proboterror/bkm-129x-scart-vga/bkm-129x-scart-vga.kicad_pcb

## KiCad design bkm-129x-scart-vga.kicad_pcb (2025-03-08)

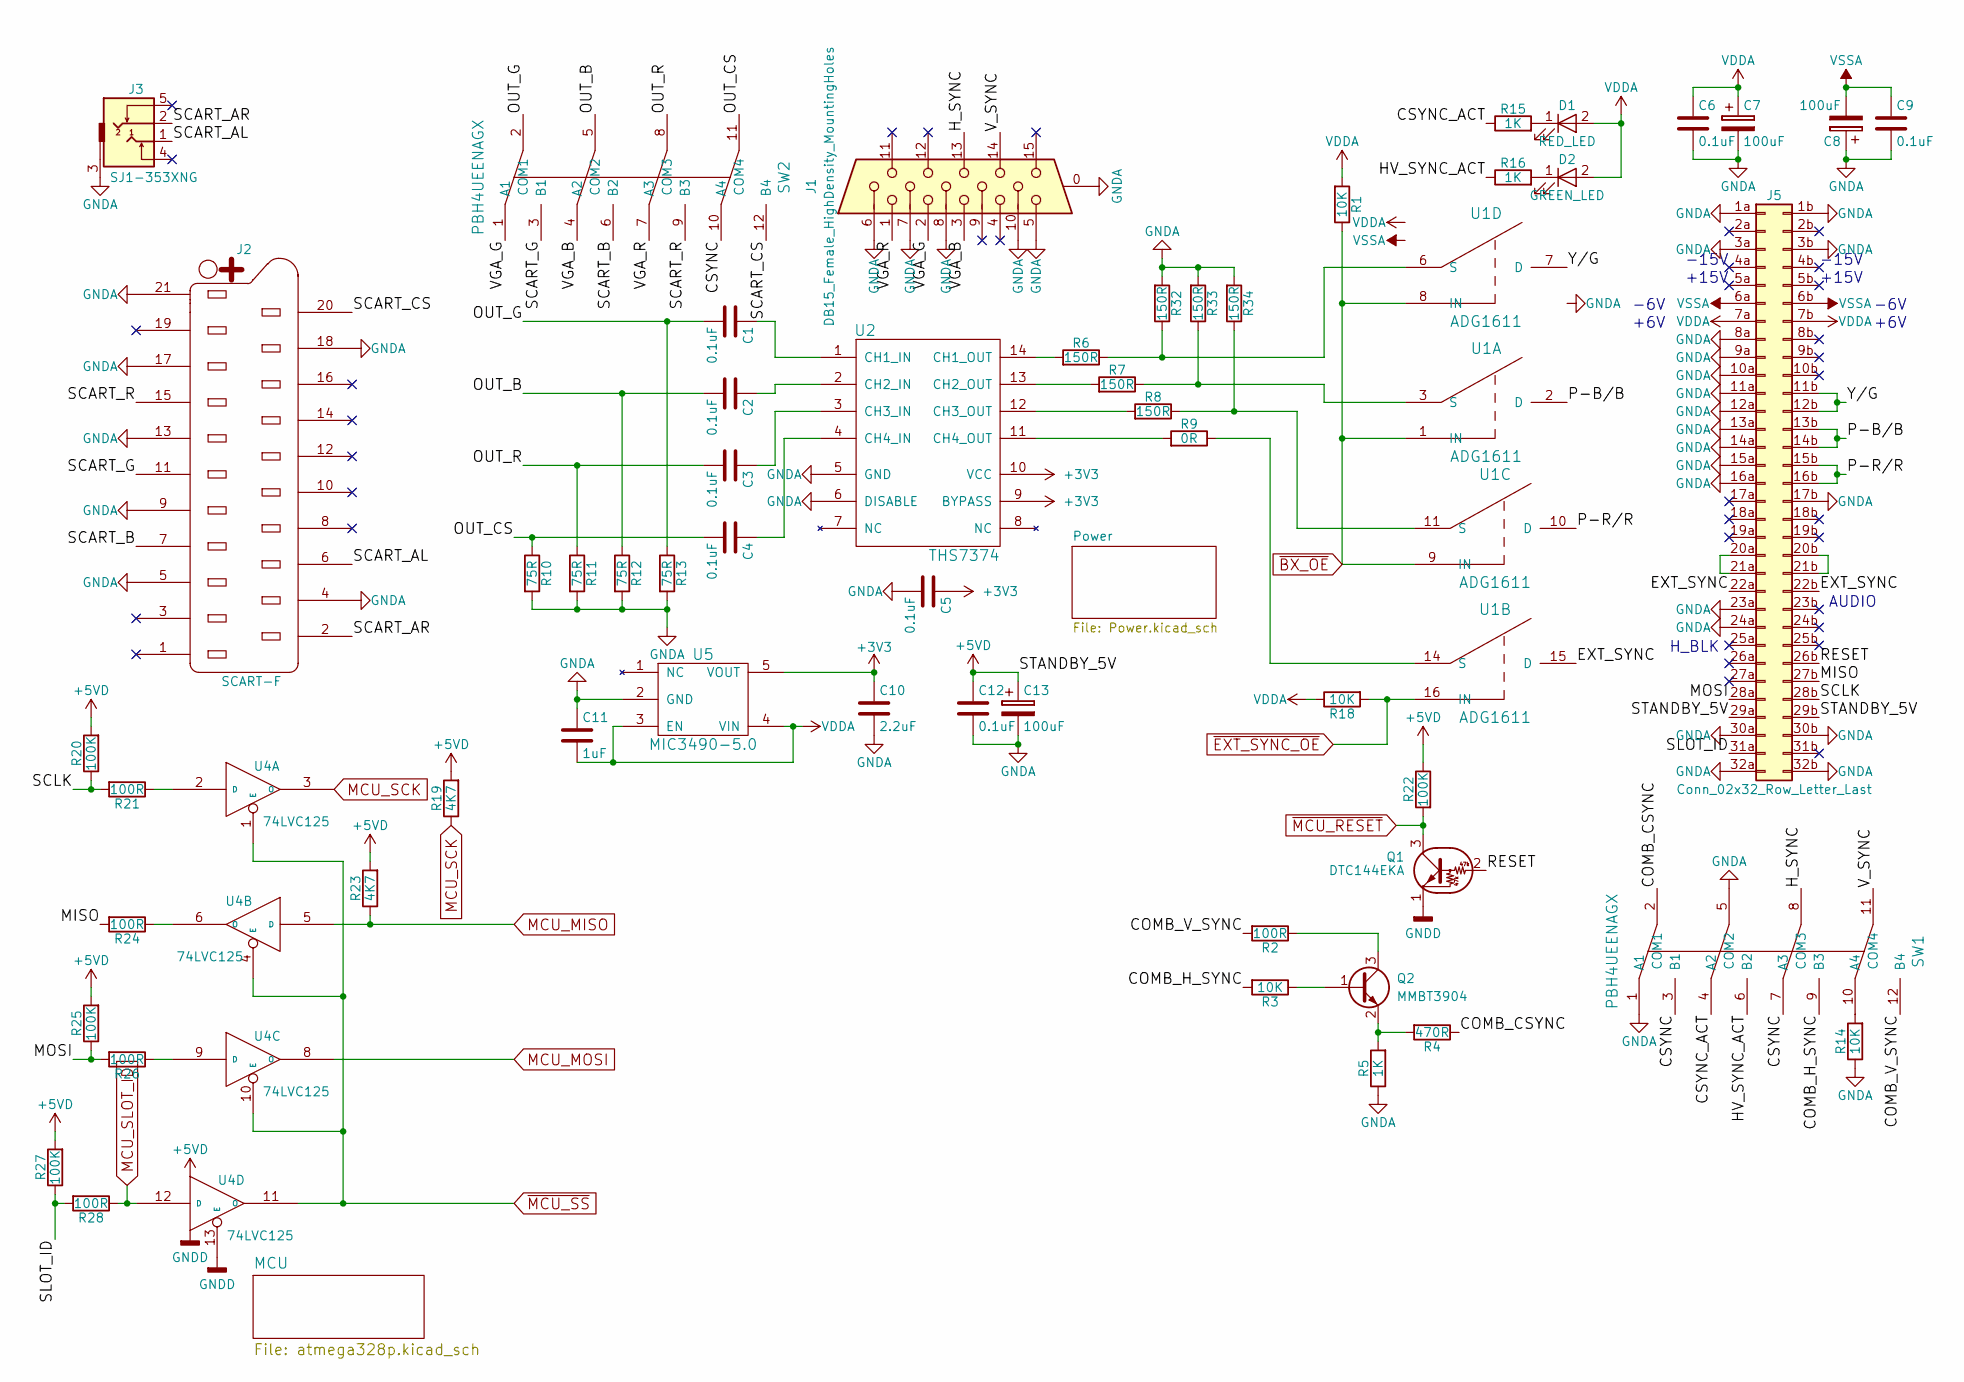
[picture p1: schematic bkm-129x-scart-vga.kicad_sch, BKM-129X Compatible SCART/VGA Board]

Parts:
C1, C2, C3, C4, C5, C6, C9, C12: 0.1uF; C_0805_2012Metric_Pad1.18x1.45mm_HandSolder
C7, C8, C13: 100uF; CP_Elec_6.3x5.3
C10: 2.2uF; C_0805_2012Metric_Pad1.18x1.45mm_HandSolder
C11: 1uF; C_0805_2012Metric_Pad1.18x1.45mm_HandSolder
D1: RED_LED; D_0805_2012Metric_Pad1.15x1.40mm_HandSolder
D2: GREEN_LED; D_0805_2012Metric_Pad1.15x1.40mm_HandSolder
J1: DB15_Female_HighDensity_MountingHoles; HD15-VGA
J2: SCART-F; NINIGI-SCART-RA
J3: SJ1-353XNG
J5: Conn_02x32_Row_Letter_Last; STANDARD-PIN-64P-RA
Q1: DTC144EKA; SC-59_Handsoldering
Q2: MMBT3904; SOT-23_Handsoldering
R1, R3, R14, R18: 10K; R_0805_2012Metric_Pad1.20x1.40mm_HandSolder
R2, R21, R24, R26, R28: 100R; R_0805_2012Metric_Pad1.20x1.40mm_HandSolder
R4: 470R; R_0805_2012Metric_Pad1.20x1.40mm_HandSolder
R5, R15, R16: 1K; R_0805_2012Metric_Pad1.20x1.40mm_HandSolder
R6, R7, R8, R32, R33, R34: 150R; R_0805_2012Metric_Pad1.20x1.40mm_HandSolder
R9: 0R; R_0805_2012Metric_Pad1.20x1.40mm_HandSolder
R10, R11, R12, R13: 75R; R_0805_2012Metric_Pad1.20x1.40mm_HandSolder
R19, R23: 4K7; R_0805_2012Metric_Pad1.20x1.40mm_HandSolder
R20, R22, R25, R27: 100K; R_0805_2012Metric_Pad1.20x1.40mm_HandSolder
SW1, SW2: PBH4UEENAGX; PBH4UEE
U1: ADG1611; TSSOP-16_4.4x5mm_P0.65mm
U2: THS7374; TSSOP-14_4.4x5mm_P0.65mm
U4: 74LVC125; SOIC-14_3.9x8.7mm_P1.27mm
U5: MIC3490-5.0; SOT-23-5_HandSoldering

Connections:
+3V3: C5.1, C10.1, U2.9 (BYPASS), U2.10 (VCC), U5.5 (VOUT); also elsewhere on the board
+5VD: C12.1, C13.1, J5.29a, J5.29b, R19.2, R20.2, R22.1, R23.2, R25.2, R27.2, U4.14 (VCC); also elsewhere on the board
/COMB_CSYNC: R4.1, SW1.2 (COM1)
/COMB_H_SYNC: R3.2, SW1.9 (B3)
/COMB_V_SYNC: R2.2, SW1.12 (B4)
/CSYNC: SW1.3 (B1), SW1.7 (A3), SW2.10 (A4)
/CSYNC_ACT: R15.1, SW1.4 (A2)
/EXT_SYNC: J5.22a, J5.22b, U1.15 (D)
/HV_SYNC_ACT: R16.1, SW1.6 (B2)
/H_SYNC: J1.13, SW1.8 (COM3)
/MISO: J5.27b, R24.2
/MOSI: J5.28a, R25.1, R26.2
/OUT_B: C2.2, R12.1, SW2.5 (COM2)
/OUT_CS: C4.2, R10.1, SW2.11 (COM4)
/OUT_G: C1.2, R13.1, SW2.2 (COM1)
/OUT_R: C3.2, R11.1, SW2.8 (COM3)
/P-B/B: J5.13b, J5.14b, U1.2 (D)
/P-R/R: J5.15b, J5.16b, U1.10 (D)
/RESET: J5.26b, Q1.2 (B)
/SCART_AL: J2.6, J3.1
/SCART_AR: J2.2, J3.2
/SCART_B: J2.7, SW2.6 (B2)
/SCART_CS: J2.20, SW2.12 (B4)
/SCART_G: J2.11, SW2.3 (B1)
/SCART_R: J2.15, SW2.9 (B3)
/SCLK: J5.28b, R20.1, R21.2
/SLOT_ID: J5.31a, R27.1, R28.2
/VGA_B: J1.3, SW2.4 (A2)
/VGA_G: J1.2, SW2.1 (A1)
/VGA_R: J1.1, SW2.7 (A3)
/V_SYNC: J1.14, SW1.11 (COM4)
/Y/G: J5.11b, J5.12b, U1.7 (D)
MCU_MISO: R23.1, U4.5 (D); also elsewhere on the board
MCU_MOSI: U4.8 (O); also elsewhere on the board
MCU_SCK: R19.1, U4.3 (O); also elsewhere on the board
MCU_SLOT_ID: R28.1, U4.12 (D); also elsewhere on the board
unnamed: D1.1 (K), R15.2
unnamed: D2.1 (K), R16.2
unnamed: J5.20a, J5.21a
unnamed: J5.20b, J5.21b
unnamed: Q2.1 (B), R3.1
unnamed: Q2.3 (C), R2.1
unnamed: Q2.2 (E), R4.2, R5.2
unnamed: R14.2, SW1.10 (A4)
unnamed: R7.1, R33.1, U1.3 (S)
unnamed: R9.1, U1.14 (S)
unnamed: R8.1, R34.1, U1.11 (S)
unnamed: R6.1, R32.1, U1.6 (S)
unnamed: C1.1, U2.1 (CH1_IN)
unnamed: R6.2, U2.14 (CH1_OUT)
unnamed: C2.1, U2.2 (CH2_IN)
unnamed: R7.2, U2.13 (CH2_OUT)
unnamed: C3.1, U2.3 (CH3_IN)
unnamed: R8.2, U2.12 (CH3_OUT)
unnamed: C4.1, U2.4 (CH4_IN)
unnamed: R9.2, U2.11 (CH4_OUT)
unnamed: R21.1, U4.2 (D)
unnamed: R24.1, U4.6 (O)
unnamed: R26.1, U4.9 (D)
VDDA: C6.1, C7.1, C11.2, D1.2 (A), D2.2 (A), J5.7a, J5.7b, R1.2, R18.1, U1.13 (VDD), U5.3 (EN), U5.4 (VIN); also elsewhere on the board
VSSA: C8.2, C9.1, J5.6a, J5.6b, U1.4 (VSS)
~BX_OE: R1.1, U1.1 (IN), U1.8 (IN), U1.9 (IN); also elsewhere on the board
~EXT_SYNC_OE: R18.2, U1.16 (IN); also elsewhere on the board
~MCU_RESET: Q1.3 (C), R22.2; also elsewhere on the board
~MCU_SS: U4.1 (E), U4.4 (E), U4.10 (E), U4.11 (O); also elsewhere on the board

Notes on the sheet:
+15V
-6V
H_BLK
+6V
AUDIO
-15V

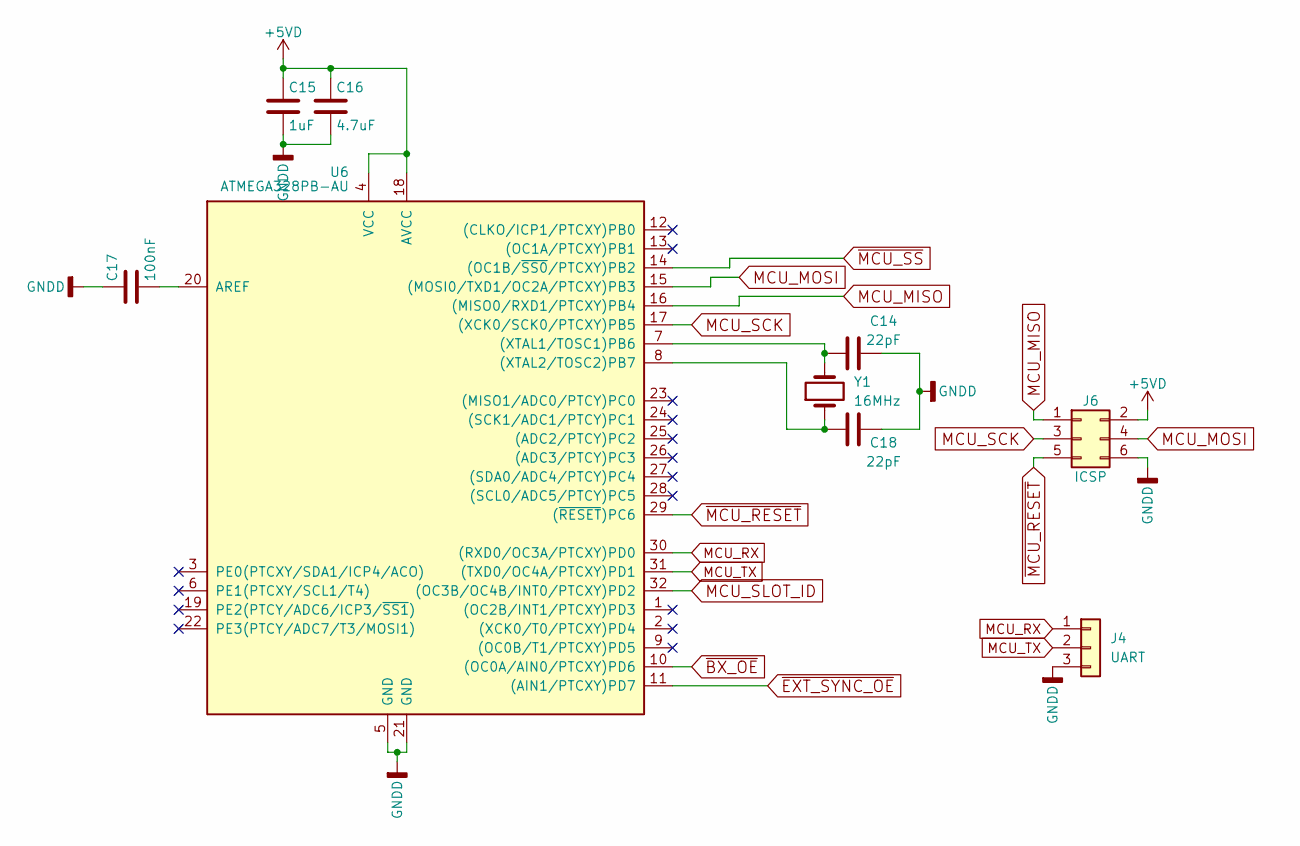
[picture p2: schematic atmega328p.kicad_sch, BKM-129X Compatible full, onboard MCU]

Parts:
C14, C18: 22pF; C_0805_2012Metric_Pad1.18x1.45mm_HandSolder
C15: 1uF; C_0805_2012Metric_Pad1.18x1.45mm_HandSolder
C16: 4.7uF; C_0805_2012Metric_Pad1.18x1.45mm_HandSolder
C17: 100nF; C_0805_2012Metric_Pad1.18x1.45mm_HandSolder
J4: UART; PinHeader_1x03_P2.54mm_Vertical
J6: ICSP; Pin_Header_Straight_2x03_Pitch2.54mm
U6: ATMEGA328PB-AU; TQFP-32_7x7mm_P0.8mm
Y1: 16MHz; Crystal_HC49-U_Vertical

Connections:
+5VD: C15.1, C16.1, J6.2, U6.4 (VCC), U6.18 (AVCC); also elsewhere on the board
MCU_MISO: J6.1, U6.16 ((MISO0/RXD1/PTCXY)PB4); also elsewhere on the board
MCU_MOSI: J6.4, U6.15 ((MOSI0/TXD1/OC2A/PTCXY)PB3); also elsewhere on the board
MCU_RX: J4.1, U6.30 ((RXD0/OC3A/PTCXY)PD0)
MCU_SCK: J6.3, U6.17 ((XCK0/SCK0/PTCXY)PB5); also elsewhere on the board
MCU_SLOT_ID: U6.32 ((OC3B/OC4B/INT0/PTCXY)PD2); also elsewhere on the board
MCU_TX: J4.2, U6.31 ((TXD0/OC4A/PTCXY)PD1)
unnamed: C14.1, U6.7 ((XTAL1/TOSC1)PB6), Y1.2
unnamed: C18.1, U6.8 ((XTAL2/TOSC2)PB7), Y1.1
unnamed: C17.2, U6.20 (AREF)
~BX_OE: U6.10 ((OC0A/AIN0/PTCXY)PD6); also elsewhere on the board
~EXT_SYNC_OE: U6.11 ((AIN1/PTCXY)PD7); also elsewhere on the board
~MCU_RESET: J6.5, U6.29 ((~RESET)PC6); also elsewhere on the board
~MCU_SS: U6.14 ((OC1B/~SS0/PTCXY)PB2); also elsewhere on the board

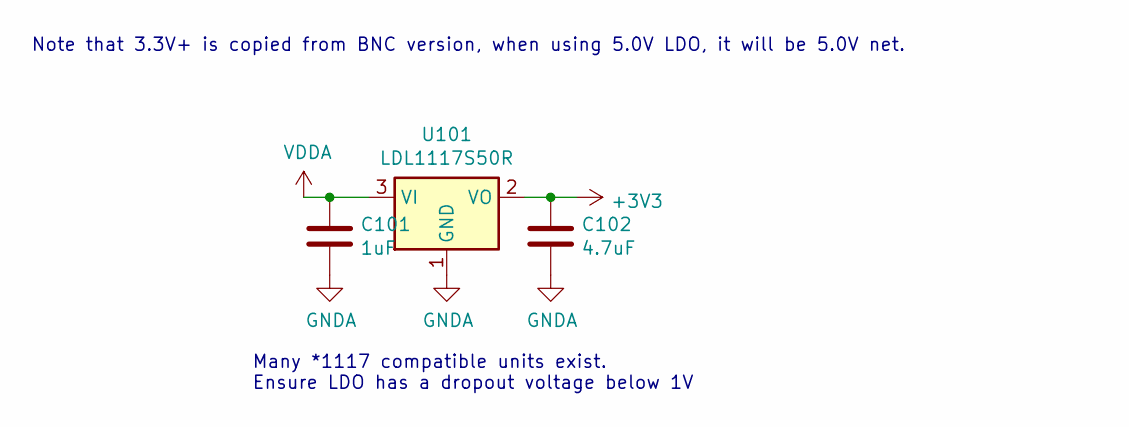
[picture p3: schematic Power.kicad_sch]

Parts:
C101: 1uF; C_0805_2012Metric_Pad1.18x1.45mm_HandSolder
C102: 4.7uF; C_0805_2012Metric_Pad1.18x1.45mm_HandSolder
U101: LDL1117S50R; SOT-223-3_TabPin2

Connections:
+3V3: C102.1, U101.2 (VO); also elsewhere on the board
VDDA: C101.1, U101.3 (VI); also elsewhere on the board

Notes on the sheet:
Note that 3.3V+ is copied from BNC version, when using 5.0V LDO, it will be 5.0V net.
Many *1117 compatible units exist. Ensure LDO has a dropout voltage below 1V

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
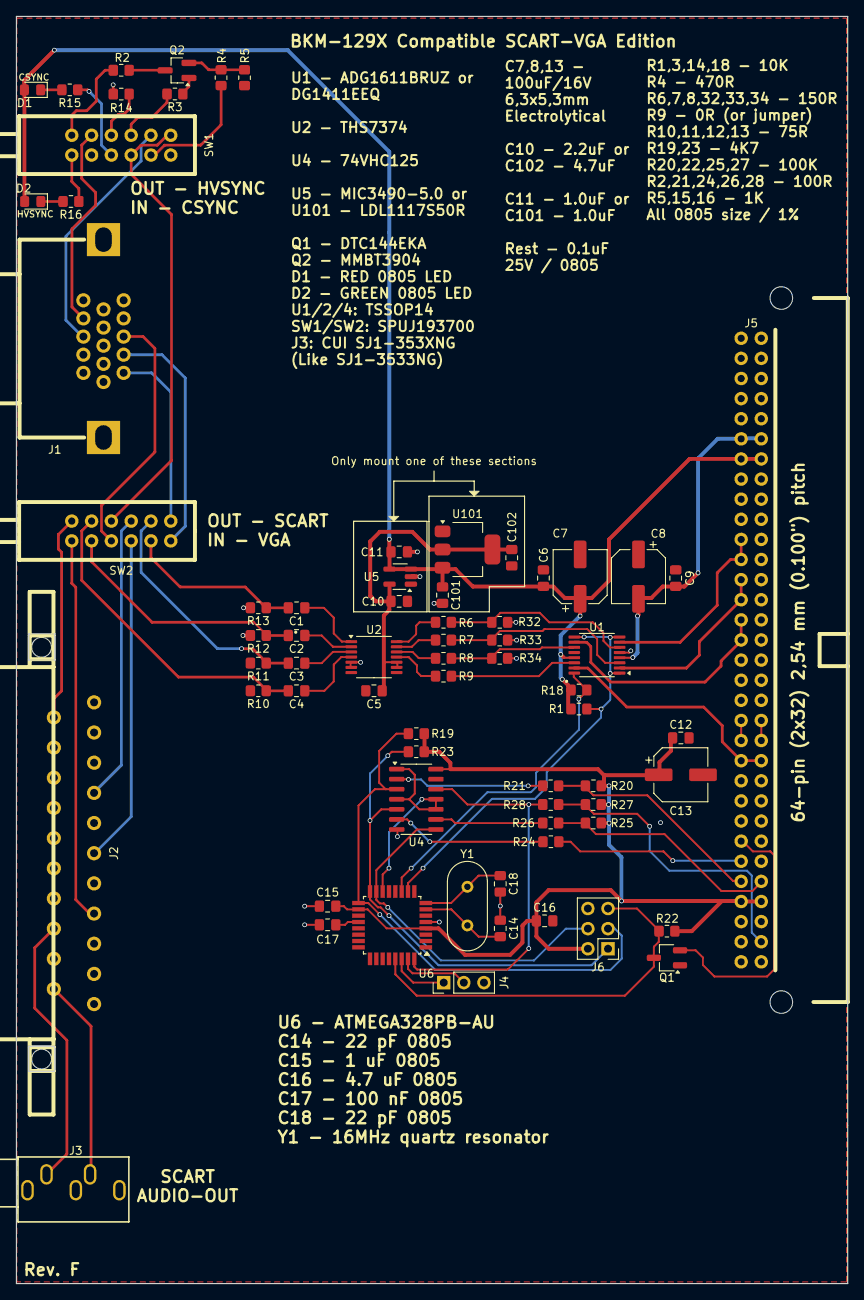
[picture p4: board bkm-129x-scart-vga.kicad_pcb from above]

Board: 2 copper layers, 105.0 x 160.0 mm, 69 parts (0 on the bottom side), 71 nets.
