proboterror/bkm-129x-scart-vga/(commit log)

2025-01-08 Convert to KiCad 8.0.
    [Power.kicad_sch, atmega328p.kicad_sch, bkm-129x-scart-vga.kicad_pcb, bkm-129x-scart-vga.kicad_sch]
2025-01-08 Edit J1 VGA DB15: Move X -0.7775 mm Edit footprint silkscreen matching board edge Change mounting holes to: Pad shape: Rectangular 4.2 x 4.2, Hole shape: Oval 3.2 x 2.2.
    Unfill all zones.
    [bkm-129x-scart-vga.kicad_pcb]
2025-01-09 Edit SW1, SW2: Move X 0.4 mm Remove mounting holes
    [bkm-129x-scart-vga.kicad_pcb]
2025-01-09 Remove U3 Arduino Nano from PCB and schematic.
    [Power.kicad_sch, bkm-129x-scart-vga.kicad_pcb, bkm-129x-scart-vga.kicad_sch]
2025-01-09 Replace CSTNE16M0VH3L000R0 ceramic resonator with HC49S quartz crystal and capacitors.
    [atmega328p.kicad_sch]
2025-01-09 Update PCB from schematic, arrange MCU components on PCB.
    [bkm-129x-scart-vga.kicad_pcb]
2025-01-09 Add debug UART connector to schematic and PCB. Edit silkscreen MCU description.
    [atmega328p.kicad_sch, bkm-129x-scart-vga.kicad_pcb]
2025-01-10 Add J5 DIN41612_B_2x32_Male_Horizontal_THT mounting holes with 2 mm clearance.
    [bkm-129x-scart-vga.kicad_pcb]
2025-01-10 Edit SW1, SW2 footprint: move silkscreen drawing: X: -0.45
    [bkm-129x-scart-vga.kicad_pcb]
2025-01-10 Add github link to PCB silkscreen.
    [bkm-129x-scart-vga.kicad_pcb]
2025-01-10 Change C14, C18 footprints from 1206 to 0805.
    [atmega328p.kicad_sch, bkm-129x-scart-vga.kicad_pcb]
2025-01-10 Change U4 footprint to TSSOP-14 (74LVC125AD.112).
    [bkm-129x-scart-vga.kicad_pcb, bkm-129x-scart-vga.kicad_sch]
2025-01-10 Update PCB silkscreen description.
    [bkm-129x-scart-vga.kicad_pcb]
2025-01-11 PCB: change input analog RGBS tracks width from 0.25 to 0.35 mm.
    [bkm-129x-scart-vga.kicad_pcb]
2025-01-11 PCB: fix DRC warnings: update footprints.
    [bkm-129x-scart-vga.kicad_pcb]
2025-01-11 * PCB: change output analog RGBS tracks width from 0.25 to 0.35 mm.
    [bkm-129x-scart-vga.kicad_pcb]
2025-03-08 Edit PCB silkscreen BOM description: 74VHC125 not 74LVC125 See comment https://www.reddit.com/r/crtgaming/comments/f5u1zo/bkm129x_cheapedition/ 74LVC125AD112 (NXP/Nexperia) is not compatible. Tested 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
    [bkm-129x-scart-vga.kicad_pcb]
